yebrian1/Project-NUEVO/plot.png

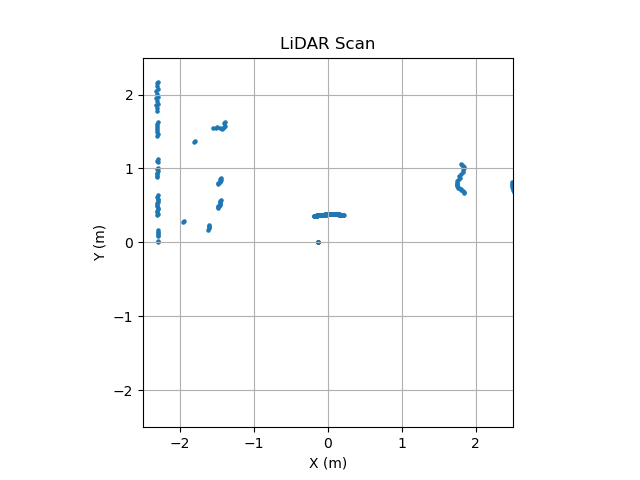
plot.png
