yebrian1/Project-NUEVO/robot_team.jpeg

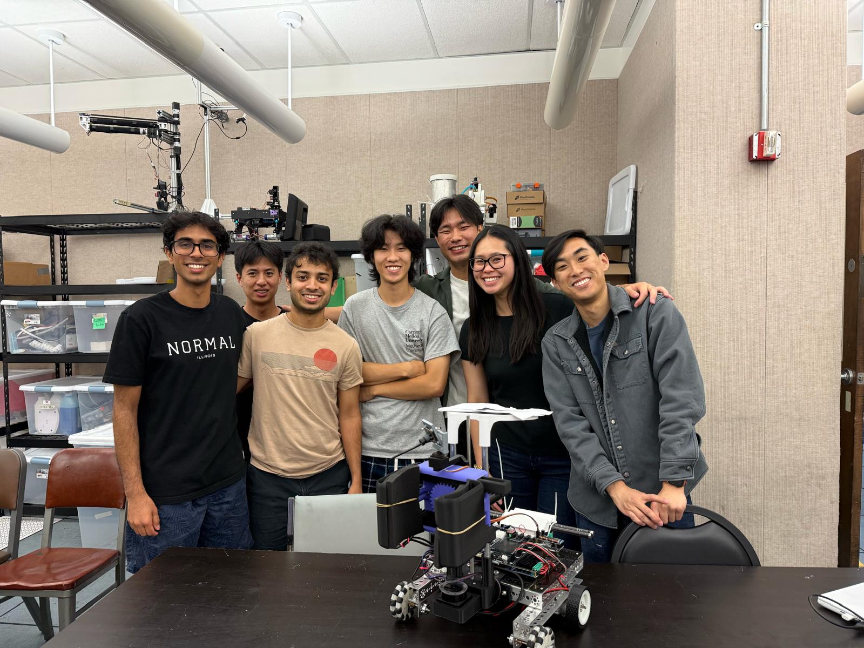
robot_team.jpeg
