yebrian1/Project-NUEVO/docs/lab_manual/Lab1_ROS2/main.tex

\documentclass{ol-softwaremanual}

% Packages used in this example
\usepackage{graphicx}  % for including images
\usepackage{microtype} % for typographical enhancements
\usepackage{amsmath}   % for equations and mathematics
\usepackage{minted}    % for styled code blocks (requires -shell-escape + Pygments)
\usepackage{hyperref}  % for hyperlinks
\usepackage[a4paper,top=4.2cm,bottom=4.2cm,left=3.5cm,right=3.5cm]{geometry}

% Additional packages for lab content
\usepackage{enumitem}
\usepackage{changepage}  % for adjustwidth (wider code blocks)

% Code block style: light gray background, small monospace font, line wrapping
\setminted{style=friendly, bgcolor=gray!10, fontsize=\small, breaklines=true, breakanywhere=true}

% Wider code blocks: extend codemargin into each margin, normal text width unchanged
\newlength{\codemargin}
\setlength{\codemargin}{1.0cm}
\AddToHook{env/minted/before}{%
  \begin{adjustwidth}{-\codemargin}{-\codemargin}%
  \addtolength{\hsize}{2\codemargin}%
}
\AddToHook{env/minted/after}{\end{adjustwidth}}

% Give LaTeX extra inter-word stretch to avoid overfull boxes from long \texttt paths
\setlength{\emergencystretch}{2em}

% Machine-location badges for task headings
%   \onlaptop  — green badge, steps performed on the student laptop
%   \onrpi     — blue badge,  steps performed on the Raspberry Pi
\newcommand{\onlaptop}{%
  \,\colorbox{green!25}{\footnotesize\sffamily\bfseries Laptop}}
\newcommand{\onrpi}{%
  \,\colorbox{blue!20}{\footnotesize\sffamily\bfseries RPi}}
\newcommand{\onui}{%
  \,\colorbox{yellow!50}{\footnotesize\sffamily\bfseries UI (browser)}}

% Machine-context callout used at the start of each Task subsection
%   #1 = machine label text,  #2 = brief description
\newcommand{\machinebox}[2]{%
  \par\noindent
  \colorbox{gray!12}{\parbox{\dimexpr\linewidth-2\fboxsep}{%
    \small\sffamily\textbf{Where to run:} #1 \quad\textbar\quad #2}}%
  \par\smallskip}

% Custom macros used in this example document
\newcommand{\doclink}[2]{\href{#1}{#2}}
\newcommand{\cs}[1]{\texttt{\textbackslash #1}}

% Match original template cover spacing:
%   ~30% whitespace, logo, large gap, title+version, vfill, author+date
\makeatletter
\renewcommand\maketitle{%
  \begin{titlepage}
  \centering
  \vspace*{0.18\textheight}
  \@logocmd\par
  \vspace{0.10\textheight}
  {\huge\bfseries\@title\par}
  \bigskip
  {\Large\@ver\par}
  \vfill
  {\Large\@author\par}
  \@date
  \vspace{0.06\textheight}
  \end{titlepage}
}
\makeatother

% Frontmatter data; appears on title page
\title{Lab 1: ROS2 Introduction and System Integration}
\version{0.1.3}
\author{162 TAs and Maclab members}
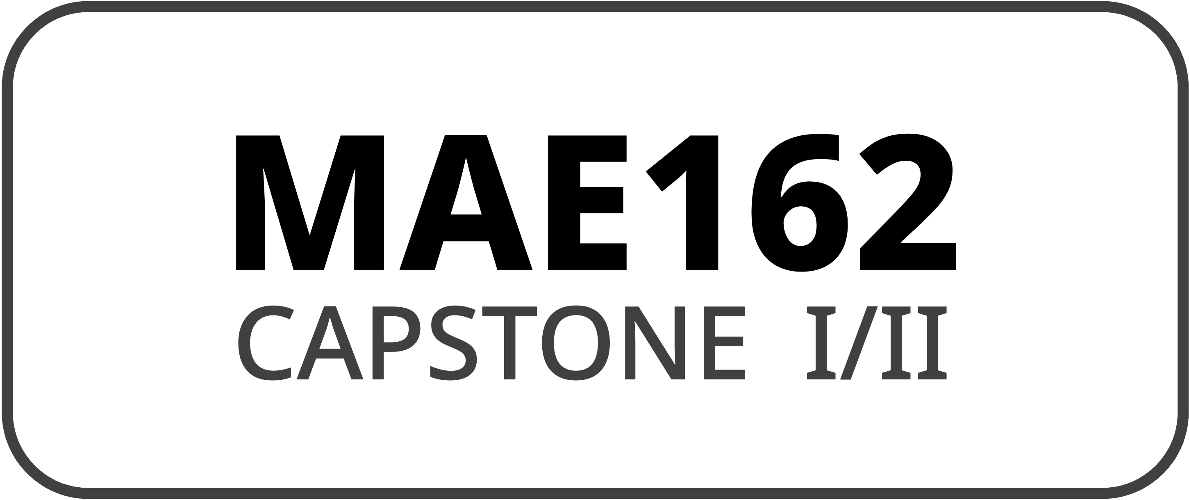
[picture p5: docs/lab_manual/Lab1_ROS2/figures/capstone.png]
\softwarelogo{}

\begin{document}

\maketitle

\centerline{\textbf{Warning!}}
\begin{itemize}
    \item No food and drinks are allowed in the lab.
    \item Be careful with the hardware especially the electronics.  Any liquid spill can cause a short circuit, potentially significantly delaying your progress.
    \item Never generate a short circuit.
    \item Connect electric wires only when you are sure about what you are doing.
    \item Be gentle to the buttons! You are liable to the damage made to the robot and its electronics.
    \item Wash your hands after each experiment, some components may contain some lead.
    \item Do not run experiments on the table for the chance the robot may fall on the floor and get damaged.
\end{itemize}
\pagebreak

\tableofcontents
\newpage

\section{System Architecture}

Figure~\ref{fig:system_architecture} shows the full system architecture of Project NUEVO.
The system is divided into several blocks that communicate over well-defined interfaces.
Understanding this structure is essential for debugging and extending the robot.
For a comprehensive reference covering all subsystems, see
\doclink{https://github.com/pochihh/Project-NUEVO/blob/main/docs/manual/MANUAL.md}{\texttt{docs/manual/MANUAL.md}}.

\begin{figure}[h]
  \centering
  
  \caption{System Architecture.}
  \label{fig:system_architecture}
\end{figure}

\subsection*{PCB and Firmware}
The custom PCB hosts an \textbf{Arduino Mega 2560} microcontroller and breaks out
the following hardware channels:

\begin{itemize}
  \item \textbf{4 DC motor channels} with quadrature encoder feedback
  \item \textbf{4 stepper motor channels} (A4988/DRV8825 drivers)
  \item \textbf{16 servo channels} via a PCA9685 I\textsuperscript{2}C PWM controller
  \item \textbf{IMU} (ICM-20948: accelerometer, gyroscope, magnetometer)
  \item \textbf{Voltage monitoring} for the battery rail, 5\,V rail, and servo rail
  \item \textbf{User I/O}: buttons, discrete LEDs, and NeoPixel RGB LEDs
  \item \textbf{Limit switches} and expandable ultrasonic sensor slots
\end{itemize}

The firmware is the only component that directly controls the actuators and reads
hardware encoders; all other layers communicate with it through the bridge.

For full firmware details refer to:
\begin{itemize}
  \item \doclink{https://github.com/pochihh/Project-NUEVO/blob/main/firmware/README.md}{\texttt{firmware/README.md}} --- build, upload, and configuration overview
  \item \doclink{https://github.com/pochihh/Project-NUEVO/blob/main/firmware/arduino/src/config.h}{\texttt{firmware/arduino/src/config.h}} --- all compile-time settings (channel counts, gains, rates)
  \item \doclink{https://github.com/pochihh/Project-NUEVO/blob/main/firmware/docs/architecture.md}{\texttt{firmware/docs/architecture.md}} --- runtime task structure and startup order
  \item \doclink{https://github.com/pochihh/Project-NUEVO/blob/main/docs/COMMUNICATION_PROTOCOL.md}{\texttt{docs/COMMUNICATION\_PROTOCOL.md}} --- TLV protocol, message catalog, and state machine
  \item \doclink{https://github.com/pochihh/Project-NUEVO/blob/main/tlv_protocol/TLV_Payloads.md}{\texttt{tlv\_protocol/TLV\_Payloads.md}} --- exact payload byte layouts and IDs
\end{itemize}

\subsection*{Bridge}
The bridge is a Python process running on the \textbf{Raspberry Pi~5}.
It owns the single UART connection to the Arduino (\texttt{/dev/ttyAMA0} at 200\,kbaud)
and translates between the compact TLV wire protocol and higher-level interfaces.
In addition to the transport layer, the bridge runs a \textbf{FastAPI/WebSocket server}
that serves the NUEVO web UI.
When running inside the ROS2 Docker container, the bridge also publishes and subscribes
to ROS2 topics and services, acting as the boundary between the real-time firmware world
and the robot application layer.

Refer to:
\begin{itemize}
  \item \doclink{https://github.com/pochihh/Project-NUEVO/blob/main/docs/ros2/bridge_runtime.md}{\texttt{docs/ros2/bridge\_runtime.md}} --- bridge architecture, shared runtime model, and reset recovery
  \item \doclink{https://github.com/pochihh/Project-NUEVO/blob/main/docs/COMMUNICATION_PROTOCOL.md}{\texttt{docs/COMMUNICATION\_PROTOCOL.md}} --- TLV protocol, message catalog, and state machine
\end{itemize}

\subsection*{NUEVO UI}
The NUEVO UI is a \textbf{React} web application served by the bridge backend.
It provides a dashboard for testing and monitoring all hardware in real time:
motor speed setpoints and feedback, stepper positions, servo angles, LED color,
user button states, IMU readings, voltage levels, and odometry.
You access it from any browser on the same network by navigating to the
Raspberry Pi's IP address at port~8000.

Refer to:
\begin{itemize}
  \item \doclink{https://github.com/pochihh/Project-NUEVO/blob/main/ros2_ws/README.md}{\texttt{ros2\_ws/README.md}} --- build instructions for the frontend and how to start the bridge that serves the UI
\end{itemize}

\subsection*{Robot Node}
The \texttt{robot} ROS2 package is where high-level \textbf{decision-making and path planning}
code lives.
It subscribes to sensor and state topics published by the bridge, computes motion commands,
and publishes velocity setpoints back to the bridge for execution.
In this lab the robot node is a scaffold; you will extend it in future labs.

\subsection*{Sensor Node}
The \texttt{sensors} ROS2 package handles \textbf{Raspberry Pi--connected sensors}
that are not part of the Arduino firmware, such as GPS receivers and external range sensors
(LiDAR, ultrasonic modules, etc.).
It publishes sensor data as ROS2 topics for the robot node to consume.

\subsection*{Vision Node}
The \texttt{vision} ROS2 package handles the \textbf{camera pipeline and object detection}.
It reads frames from the camera, runs inference (e.g.\ YOLO), and publishes detection results
as ROS2 topics.
The vision dependencies (OpenCV, libcamera, YOLO) are heavier than the rest of the stack
and are added to the Docker image separately.

Refer to the following for the Robot, Sensor, and Vision nodes:
\begin{itemize}
  \item \doclink{https://github.com/pochihh/Project-NUEVO/blob/main/docs/ros2/ros2_nodes_design.md}{\texttt{docs/ros2/ros2\_nodes\_design.md}} --- package layout, design principles, and topic/service naming
  \item \doclink{https://github.com/pochihh/Project-NUEVO/blob/main/ros2_ws/README.md}{\texttt{ros2\_ws/README.md}} --- Docker workflow, node startup order, and ROS2 API overview
\end{itemize}

\subsection*{Why ROS2 and Docker?}
With this architecture, each component has a single responsibility and communicates
through a standardised message-passing system.
Adding a new sensor, planner, or perception algorithm means writing a new node
that subscribes and publishes standard topics --- the rest of the system does not change.
Docker ensures that every team member and every Raspberry Pi runs the \emph{exact same}
software environment regardless of the host operating system, eliminating
``it works on my machine'' problems and making deployment to the robot a one-command step.

\section{ROS2 Introduction}

\subsection{Core Concepts}

ROS2 (Robot Operating System~2) is an open-source middleware framework for building
robot software.
Despite the name it is not an operating system: it is a set of libraries, tools, and
conventions that run on top of a standard OS and let independently developed programs
communicate with each other cleanly.

\textbf{Nodes} are the basic executable units.
Each node is a process (or a thread within a process) that performs one focused task ---
reading a sensor, running a controller, publishing odometry.
In this project: \texttt{bridge}, \texttt{robot}, \texttt{sensor\_node}, and
\texttt{vision\_node} are each a separate node.

\textbf{Topics} are named communication channels that carry a stream of messages.
A node that produces data \emph{publishes} to a topic; a node that needs that data
\emph{subscribes} to it.
Topics are asynchronous and many-to-many.
For example, the bridge node publishes DC motor state on \texttt{/dc\_state\_all}
and the robot node subscribes to that topic.

\textbf{Messages} define the data structure for a topic.
They are declared in \texttt{.msg} files inside the \texttt{bridge\_interfaces} package
and compiled into language-specific code automatically.
\texttt{bridge\_interfaces/msg/DCStateAll} and \texttt{bridge\_interfaces/msg/SystemPower}
are examples used in this project.

\textbf{Services} are synchronous request--reply interactions.
A node that handles a service advertises it; another node calls it and waits for
a response.
Use services for discrete operations where you need to know whether the action
succeeded.
In this project, firmware state transitions (IDLE $\to$ RUNNING, triggering an E-stop)
use the \texttt{/set\_firmware\_state} service.

\textbf{Packages} are the unit of organisation and distribution.
A package groups related nodes, message definitions, and launch files.
This project has five packages:
\texttt{bridge\_interfaces} (message/service definitions),
\texttt{bridge} (ROS wrapper around the firmware bridge),
\texttt{robot} (motion planning),
\texttt{sensors} (Pi-side sensors), and
\texttt{vision} (camera and detection).

\medskip
\noindent\textit{Keywords for further learning:}
ROS2 publisher/subscriber, colcon build, \texttt{ros2 topic echo}, \texttt{ros2 node info},
QoS policies, launch files, parameter server, tf2 transforms, RViz2, rqt.

\subsection{Docker for ROS2}

Modern robots are developed by teams working on different machines with different
operating systems --- macOS, Windows, Ubuntu.
ROS2 Jazzy officially targets Ubuntu 24.04; running it natively on macOS or Windows
requires significant manual setup that is fragile and hard to reproduce.
Docker solves this by packaging the entire ROS2 environment --- OS libraries,
ROS installation, workspace build --- into a single \emph{container image}.
Everyone on the team starts the same image, so the software environment is
\emph{identical} whether you are developing on a laptop or deploying to the Raspberry Pi.
This also means updating the environment is a \texttt{docker compose build} rather than
a multi-step manual procedure.

In this project the Docker image contains ROS2 Jazzy, the project workspace,
and all Python runtime dependencies.
Two compose files are provided:

\begin{itemize}
  \item \texttt{ros2\_ws/docker/docker-compose.rpi.yml} --- for the Raspberry Pi with real hardware
  \item \texttt{ros2\_ws/docker/docker-compose.vm.yml} --- for macOS / Windows development (mock bridge)
\end{itemize}

\noindent\textit{Keywords for further learning:}
Dockerfile, Docker image vs.\ container, \texttt{docker compose}, volume mounts,
container networking, \texttt{docker exec}, base images.

\section{Raspberry Pi Safety and Usage}

The Raspberry Pi~5 is the compute brain of your robot.
A damaged or corrupted RPi means your whole team is blocked until it is
re-imaged or replaced --- which can take an entire lab session.
The failures we see most often are \emph{entirely preventable}.
Read this section before touching the hardware.

\subsection*{Power}

\begin{itemize}
  \item \textbf{Two valid power sources:}
        \begin{itemize}
          \item \textbf{Supplied USB-C PD adapter} (5\,V / 5\,A) --- use this
                at your bench when the robot battery is not connected.
          \item \textbf{Robot battery via the PCB} --- the PCB's onboard 5\,V
                rail is rated at 6\,A and includes a hot-swap circuit that
                safely switches between battery and bench supply.
                This is the intended power source when the robot is running
                autonomously.
        \end{itemize}
  \item \textbf{Never use a phone charger, laptop USB port, or cheap power bank.}
        These cannot supply enough current; the resulting voltage drop causes
        random crashes and SD card corruption.
  \item \textbf{Never wire the battery directly to the RPi}, bypassing the PCB.
        The PCB regulator and hot-swap circuit are there for a reason.
  \item \textbf{Never hot-swap the SD card.}
        If the card must be removed, shut down first (see below).
\end{itemize}

\subsection*{Shutdown procedure --- the most important habit}

The RPi runs a Linux filesystem.
Pulling the power while the OS is writing to the SD card --- which happens
constantly in the background --- \textbf{corrupts the filesystem}.
A corrupted SD card requires a full re-image and you lose all local work that
was not pushed to GitHub.

\medskip
\noindent\textbf{Always shut down properly before removing power:}

\begin{minted}{bash}
sudo shutdown -h now
\end{minted}

Wait for the green activity LED to stop blinking and go dark (roughly 10--15\,s),
\emph{then} unplug the power cable.
This also applies when you are finished for the day and when packing up the robot.

\subsection*{GPIO pins}

\begin{itemize}
  \item \textbf{GPIO logic level is 3.3\,V.}
        The RPi is \emph{not} 5\,V tolerant on its GPIO pins.
        Connecting a 5\,V signal directly to any GPIO pin will destroy that
        pin and may kill the entire SoC.
        Always use a level shifter or voltage divider when interfacing with
        5\,V peripherals.
  \item \textbf{Maximum current per GPIO pin is 16\,mA} (8\,mA recommended).
        Never drive an LED, motor, or relay directly from a GPIO pin without a
        current-limiting resistor or driver IC.
  \item \textbf{Never short GPIO pins together}, and keep metal objects (tools,
        loose wires, PCB offcuts) away from the board when it is powered.
        A momentary short across the wrong pins can instantly destroy the board.
  \item \textbf{Ground yourself} before handling the board.
        Touch a grounded metal surface (e.g.\ a PC chassis) or wear an ESD
        wrist strap.
        Electrostatic discharge is invisible and silent --- and permanently damages
        chips.
\end{itemize}

\subsection*{Physical handling}

\begin{itemize}
  \item Hold the board by its edges.
        Finger pressure on chips or connectors can crack solder joints.
  \item Keep the board on a \textbf{non-conductive surface} (the anti-static bag it came
        in, or a plastic tray).
        Placing it on a metal bench or a conductive surface shorts the bottom
        pads.
  \item Do not stack anything on top of the RPi when it is running.
        The processor generates significant heat; blocking airflow causes thermal
        throttling and instability.
\end{itemize}

\subsection*{SD card hygiene}

\begin{itemize}
  \item \textbf{Push your work to GitHub immediately.}
        SD cards have a finite write endurance and \emph{will} eventually fail.
        Any work that only exists on the RPi can vanish at any time (see also
        Task~1.3).
  \item Avoid running \texttt{apt upgrade} or long package installs when the
        robot is on battery --- a power cut mid-upgrade corrupts the package
        database and often requires a re-image.
  \item If the RPi fails to boot, do \emph{not} keep trying to power-cycle it.
        Note down any error messages on the HDMI output or status LEDs and ask
        the TAs for help.
\end{itemize}

\section{Lab Activities}

\subsection{Task 1: Set Up Your Repository}\label{sec:task1}

\machinebox{\onlaptop\ your laptop \textbar\ \onrpi\ Raspberry Pi}{The repo must be cloned on \emph{both} machines. Your laptop uses it for firmware (Task~\ref{sec:task2}); the RPi uses it for ROS2 (Task~\ref{sec:task3}). Day-to-day edits are made on your laptop, then pulled onto the RPi.}

In this course you will modify the Project NUEVO codebase to add features and
tune your robot.
Each team should work in their own copy of the repository so that your changes
do not affect other teams and so you can safely experiment.

\subsubsection{Fork the Repository\onlaptop}

\begin{enumerate}
  \item Go to \doclink{https://github.com/pochihh/Project-NUEVO}{github.com/pochihh/Project-NUEVO}.
  \item Click \textbf{Fork} (top-right corner) to create a copy under your own GitHub account.
    \hfill\textit{(keyword: fork)}
  \item On your forked repository page, go to \textbf{Settings $\to$ Collaborators}
        and add your teammates as collaborators so everyone can push to the same fork.
    \hfill\textit{(keyword: collaborators, repository permissions)}
\end{enumerate}

\subsubsection{Clone the Repository --- Laptop\onlaptop}

Clone your fork onto your laptop.
You will use this copy to edit firmware, run MATLAB, and push changes to GitHub.

\begin{minted}{bash}
git clone https://github.com/<your-username>/Project-NUEVO.git
cd Project-NUEVO
\end{minted}
\hfill\textit{(keyword: clone, remote)}

\subsubsection{Clone the Repository --- Raspberry Pi\onrpi}\label{ssec:clone-rpi}

SSH into the Raspberry Pi and clone the \emph{same fork} there.
The RPi copy is what Docker mounts when running the ROS2 workspace in Task~\ref{sec:task3}.

\begin{minted}{bash}
git clone https://github.com/<your-username>/Project-NUEVO.git
cd Project-NUEVO
\end{minted}

\noindent You do not normally edit code directly on the RPi.
The typical workflow is: edit on your laptop $\to$ commit $\to$ push to GitHub
$\to$ \texttt{git pull} on the RPi to bring in the latest changes.
You can make local changes on the RPi and push them back to GitHub if needed,
but be careful not to let the two clones diverge---always pull on one machine
before editing, and push promptly so your teammates stay in sync.

\noindent\textbf{Important:} the Raspberry Pi is embedded hardware and can lose
power unexpectedly, suffer SD card corruption, or need to be re-imaged at any
time. Any work that exists \emph{only} on the RPi can be lost without warning.
\textbf{Push every change to GitHub as soon as you make it.}
Never leave uncommitted or unpushed work sitting on the RPi.

\subsubsection{Daily Git Workflow\onlaptop}

Git lets your whole team work on the same codebase simultaneously.
Run these commands on your laptop:

\begin{enumerate}
  \item \textbf{Stage} the files you want to save.
\begin{minted}{bash}
git add <filename>
\end{minted}
        \hfill\textit{(keyword: staging area, working tree)}

  \item \textbf{Commit} to record a snapshot with a short message describing what you did.
\begin{minted}{bash}
git commit -m "brief description of change"
\end{minted}
        \hfill\textit{(keyword: commit, commit message)}

  \item \textbf{Push} to upload your commits to GitHub so teammates (and the RPi) can see them.
\begin{minted}{bash}
git push
\end{minted}
        \hfill\textit{(keyword: push, origin)}

  \item \textbf{Pull} to download your teammates' latest commits before you start working.
\begin{minted}{bash}
git pull
\end{minted}
        \hfill\textit{(keyword: pull, merge, rebase, merge conflict)}
\end{enumerate}

\subsubsection{Pull Updates from the Original Repository\onlaptop}

Bug fixes and new features will be released to the original repository during the
course.
To bring them into your fork, add the original repository as a second remote and
pull from it:

\begin{enumerate}
  \item Add the original repository as the \texttt{upstream} remote (one-time setup):
\begin{minted}{bash}
git remote add upstream https://github.com/pochihh/Project-NUEVO.git
\end{minted}
        \hfill\textit{(keyword: remote, upstream)}

  \item Fetch and merge the latest changes from upstream into your local branch (for updates \textbf{in the future}):
\begin{minted}{bash}
git fetch upstream
git merge upstream/main
\end{minted}
        \hfill\textit{(keyword: fetch, merge, fast-forward)}

  \item Push the merge result (the updates) to your fork:
\begin{minted}{bash}
git push
\end{minted}
\end{enumerate}

\subsection{Task 2: Flash the Firmware}\label{sec:task2}

\machinebox{\onlaptop\ your laptop}{Arduino IDE is installed on your laptop; the Arduino is connected via USB.}

The Arduino Mega firmware must be flashed onto the robot before the bridge can
communicate with it.
Full details and troubleshooting are in
\doclink{https://github.com/pochihh/Project-NUEVO/blob/main/firmware/README.md}{\texttt{firmware/\allowbreak README.md}}.

\subsubsection{Prerequisites\onlaptop}

\begin{enumerate}
  \item Install \textbf{Arduino IDE 2.x} and the \textbf{Arduino AVR Boards} core.
  \item Increase the serial buffer size so the firmware UART link does not overflow.
        Create or edit (if exists already) \texttt{platform.local.txt} for the installed AVR core and add the following text in it:
\begin{minted}{text}
compiler.cpp.extra_flags=-DSERIAL_RX_BUFFER_SIZE=512 -DSERIAL_TX_BUFFER_SIZE=256
\end{minted}
        Typical file locations (replace \texttt{1.8.7} with your installed AVR core version):

        \textit{macOS:}
\begin{minted}{text}
~/Library/Arduino15/packages/arduino/hardware/avr/1.8.7/platform.local.txt
\end{minted}
        \textit{Windows:}
\begin{minted}{text}
C:\Users\<your-user>\AppData\Local\Arduino15\packages\arduino\hardware\avr\1.8.7\platform.local.txt
\end{minted}
\end{enumerate}

\subsubsection{Build and Upload\onlaptop}

\begin{enumerate}
  \item Open \texttt{firmware/arduino/arduino.ino} in Arduino IDE.
  \item Select board: \textbf{Arduino Mega or Mega~2560}.
  \item Select the correct COM / serial port for the connected Arduino.
  \item Click \textbf{Verify} to confirm the firmware compiles without errors.
  \item Click \textbf{Upload} to flash the firmware onto the board.
\end{enumerate}

After a successful upload the board resets and the firmware starts running.
Confirm by opening the Arduino IDE Serial Monitor at 115\,200 baud and checking
for heartbeat output.

\subsection{Task 3: Bring Up the ROS2 Environment and NUEVO UI}\label{sec:task3}

\machinebox{\onrpi\ Raspberry Pi (SSH or direct terminal)}{Most steps run on the RPi. The final step (Access the NUEVO UI) opens in a browser on any device on the same network. Make sure you have already cloned your fork on the RPi (Section~\ref{ssec:clone-rpi}) and run \texttt{git pull} to get the latest code before starting.}

In this task you will start the Docker container on the Raspberry Pi, launch the
bridge node, and verify all hardware using the NUEVO web UI.
Full setup details are in
\doclink{https://github.com/pochihh/Project-NUEVO/blob/main/ros2_ws/README.md}{\texttt{ros2\_ws/README.md}}.

\subsubsection{Raspberry Pi UART Setup (one-time)\onrpi}

The bridge communicates with the Arduino over the RPi hardware UART.
Enable it by editing the RPi boot configuration files:

\begin{enumerate}
  \item Add the following lines to \texttt{/boot/firmware/config.txt}:
\begin{minted}{text}
enable_uart=1
dtoverlay=uart0-pi5
\end{minted}

  \item Remove any \texttt{console=serial0} or \texttt{console=ttyAMA0} entries
        from \texttt{/boot/firmware/cmdline.txt} so the OS does not claim the port.

  \item Reboot and verify: \texttt{ls -l /dev/ttyAMA0} should show a character
        device owned by the \texttt{dialout} group.
\end{enumerate}

\subsubsection{Install Node.js and npm (one-time)\onrpi}

The NUEVO UI frontend build uses \texttt{npm}. Install Node.js and npm on the
Raspberry Pi host first:

\begin{minted}{bash}
sudo apt update
sudo apt install -y nodejs npm
node -v
npm -v
\end{minted}

For this project, \texttt{node -v} should report a reasonably modern version
(Node 18 or newer is a safe baseline).

\subsubsection{Build the Frontend (one-time)\onrpi}

The bridge serves the NUEVO web UI as a pre-built static bundle.
Build it once from the repository root:

\begin{minted}{bash}
cd nuevo_ui/frontend
npm ci
npm run build
cd ../..
cp -r nuevo_ui/frontend/dist/. nuevo_ui/backend/static/
\end{minted}

\subsubsection{Install Docker (one-time)\onrpi}

For this class project, the simplest Docker setup on the Raspberry Pi is the
official Docker convenience script:

\begin{minted}{bash}
curl -fsSL https://get.docker.com -o get-docker.sh
sudo sh get-docker.sh
sudo usermod -aG docker $USER
newgrp docker
docker --version
docker compose version
\end{minted}

\textbf{Note:} if \texttt{newgrp docker} does not take effect cleanly in your
shell, log out and log back in once, then re-run the version checks above.

\subsubsection{Start the Docker Container\onrpi}

From the repository root on the Raspberry Pi:

\begin{minted}{bash}
COMPOSE=ros2_ws/docker/docker-compose.rpi.yml
docker compose -f $COMPOSE build
docker compose -f $COMPOSE up -d
docker compose -f $COMPOSE logs -f ros2_runtime
\end{minted}

Wait until the log shows that \texttt{colcon build} finished and the container is ready.

\subsubsection{Launch the Bridge Node\onrpi}

Open a shell inside the running container and start the bridge:

\begin{minted}{bash}
docker compose -f $COMPOSE exec ros2_runtime bash
source /opt/ros/jazzy/setup.bash
source /ros2_ws/install/setup.bash
ros2 run bridge bridge
\end{minted}

The bridge node connects to the Arduino, starts the WebSocket server, and begins
publishing ROS2 topics.

\subsubsection{Access the NUEVO UI\onui}

Open a browser on any device on the same network and navigate to:
\begin{center}
  \texttt{http://<raspberry-pi-ip>:8000}
\end{center}

Login credentials: username \texttt{user}, password \texttt{162}.
\textbf{Change your password after first login.}

Use the UI to test each hardware feature:
\begin{itemize}
  \item Set stepper motor positions and verify movement.
  \item Command servo angles and observe the mechanical response.
  \item Change LED colors via the colour picker.
  \item Press each user button and confirm the indicator updates.
  \item Check IMU readings (accelerometer, gyroscope) for expected values.
  \item Monitor the battery voltage level on the power panel.
\end{itemize}

\subsection{Task 4: DC Motor PI Tuning and Step Response}\label{sec:task4}

\machinebox{\onlaptop\ your laptop \textbar\ \onui\ NUEVO UI \textbar\ \onrpi\ RPi}{MATLAB analysis and gain calculations run on your laptop. Motor commands and data recording use the NUEVO UI in your browser. The RPi must be running the bridge node from Task~\ref{sec:task3}.}

In this task you will tune the PI velocity controller for one DC motor and record
step responses to evaluate your design.
The goal is to transition from the default gains to a set of gains that you can
justify from a simple model of the motor dynamics.

\subsubsection{Model-Based PI Design (Optional)\onui\onlaptop}\label{ssec:model-pi}

A DC motor's velocity dynamics can be approximated as a first-order linear system:
\begin{equation}
  G(s) = \frac{K}{\tau s + 1}
  \label{eq:motor_model}
\end{equation}
where $K$ is the steady-state gain (ticks/s per PWM unit) and $\tau$ is the time
constant (seconds).
You can identify both parameters from an open-loop step response.

\paragraph{Step 1: Measure the open-loop step response.}
In the NUEVO UI, switch the motor to \textbf{PWM mode} and apply a step change in
PWM from 0 to a fixed value (e.g.\ 128 out of 255, or about 50\,\%).
Record the velocity $\omega(t)$ response using the UI's plot feature.

From the recorded curve:
\begin{itemize}
  \item $K = \omega_{ss} / u$ \quad where $u$ is the \emph{actual integer PWM value you
        applied} (0--255, \emph{not} 1).
        For example, if you applied PWM\,=\,128 and the motor settled at
        $\omega_{ss} = 980$\,ticks/s, then $K = 980/128 \approx 7.66$\,ticks/s per PWM
        unit.
  \item $\tau$ = the time at which $\omega(t)$ first reaches $63.2\,\%$ of $\omega_{ss}$
        (read directly from the step-response plot).
\end{itemize}

\paragraph{Step 2: Design the continuous-time PI gains.}
A PI controller $C(s) = K_p + K_i/s$ with plant $G(s)$ gives a second-order
closed-loop response.
Matching coefficients to the standard form $s^2 + 2\zeta\omega_n s + \omega_n^2$
yields:
\begin{equation}
  K_p = \frac{2\zeta\omega_n\tau - 1}{K}, \qquad
  K_i = \frac{\omega_n^2 \,\tau}{K}
  \label{eq:pi_gains}
\end{equation}

Choose a desired damping ratio $\zeta = 0.7$ (a good default that balances speed and
overshoot).
Select $\omega_n$ based on a rise-time or settling-time specification of your choice,
then compute $K_p$ and $K_i$ from Equations~\eqref{eq:pi_gains}.

\paragraph{Step 3: Convert to discrete time.}
The firmware PI controller runs at $f_s = 200$\,Hz, so the sample period is
$T_s = 1/200 = 0.005$\,s.
Because the gains from Step~2 are continuous-time, they must be discretized before
they can be entered into the firmware.
Use the \textbf{Tustin (bilinear)} transform, which substitutes
\[
  s \;\longrightarrow\; \frac{2}{T_s}\,\frac{z-1}{z+1}
\]
and maps the continuous-time PI controller to a discrete difference equation.
In MATLAB, the conversion is one line:

\begin{minted}{matlab}
Ts = 0.005;                         % sample period (s)  -- 200 Hz
C_s = pid(Kp, Ki);                  % continuous-time PI
C_z = c2d(C_s, Ts, 'tustin');       % discretize via bilinear transform
display(C_z)                        % inspect the result
\end{minted}

The resulting \texttt{C\_z} object contains the discrete-time coefficients.
You can extract the numerator and denominator and verify the DC gain matches
$K_p + K_i / (j\omega)$ at low frequency.
The firmware implements the equivalent difference equation internally;
you only need to enter $K_p$ and $K_i$ (the continuous-time values) through
the UI---the firmware's built-in discretization handles the rest at runtime.

\subsubsection{Simple Observation (Alternative)\onui}\label{ssec:simple-obs}

If you prefer a faster approach, skip the model identification and instead adjust
$K_p$ and $K_i$ manually while observing the step response:
increase $K_p$ to speed up the response, increase $K_i$ to eliminate steady-state
error, and reduce both if the response oscillates.

\subsubsection{Record and Compare Step Responses\onui\onlaptop}

Using the NUEVO UI, command a velocity step from 0 to 1000 ticks/s and record the
response for:
\begin{enumerate}
  \item The \textbf{default} PI gains (as shipped in \texttt{firmware/\allowbreak arduino/\allowbreak src/\allowbreak config.h}).
  \item Your \textbf{tuned} gains from Section~\ref{ssec:model-pi} or~\ref{ssec:simple-obs}.
\end{enumerate}

On each plot, annotate:
\begin{itemize}
  \item Rise time $t_r$ (time to go from 10\,\% to 90\,\% of the setpoint)
  \item Percent overshoot $M_p$
  \item Settling time $t_s$ (time to stay within $\pm 5\,\%$ of the setpoint)
  \item Steady-state error $e_{ss}$
\end{itemize}

Figure~\ref{fig:example_step} shows an example plot.

\begin{figure}[h]
  \centering
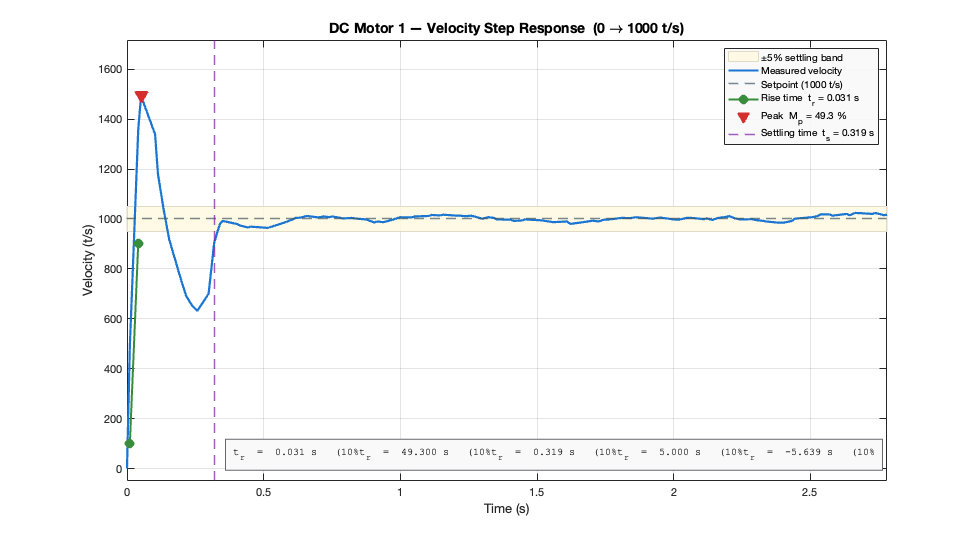
[picture p6: docs/lab_manual/Lab1_ROS2/figures/example_step.png]
  
  \caption{Example annotated velocity step response (0 $\to$ 1000\,ticks/s).
           The shaded region is the $\pm5\,\%$ settling band.}
  \label{fig:example_step}
\end{figure}

\section{Lab Deliverables}

Show your final step response plots to the TAs.
Your plots should include both the default and tuned step responses with the
performance metrics annotated.
Justify your tuned gains: explain how you arrived at your $K_p$ and $K_i$ values,
whether through the model-based approach or manual tuning, and discuss the
trade-offs you observed between rise time, overshoot, and settling time.

\end{document}
