yebrian1/Project-NUEVO/docs/lab_manual/Lab1_ROS2/dc_motor_1_0331_15-28.csv

Frame Index | Time (s) | Position (ticks) | Velocity (t/s) | Current (mA) | PWM
0 | 0 | 0 | 0 | -1 | 0
1 | 0.041271240234375 | 0 | 0 | -1 | 0
2 | 0.0618193359375 | 0 | 0 | -1 | 0
3 | 0.08243310546875 | 0 | 0 | -1 | 0
4 | 0.102903076171875 | 0 | 0 | -1 | 0
5 | 0.1441796875 | 0 | 0 | -1 | 0
6 | 0.164718017578125 | 0 | 0 | -1 | 0
7 | 0.185482666015625 | 0 | 0 | -1 | 0
8 | 0.195895263671875 | 0 | 0 | -1 | 0
9 | 0.247421142578125 | 0 | 0 | -1 | 0
10 | 0.257862060546875 | 0 | 0 | -1 | 0
11 | 0.28854052734375 | 0 | 0 | -1 | 0
12 | 0.29895654296875 | 0 | 0 | -1 | 0
13 | 0.330059326171875 | 0 | 0 | -1 | 0
14 | 0.340563232421875 | 0 | 0 | -1 | 0
15 | 0.3715439453125 | 0 | 0 | -1 | 0
16 | 0.38197802734375 | 0 | 0 | -1 | 0
17 | 0.40298046875 | 0 | 0 | -1 | 0
18 | 0.423476806640625 | 0 | 0 | -1 | 0
19 | 0.444154296875 | 0 | 0 | -1 | 0
20 | 0.464763671875 | 0 | 0 | -1 | 0
21 | 0.485376220703125 | 0 | 0 | -1 | 0
22 | 0.495789794921875 | 0 | 0 | -1 | 0
23 | 0.5269541015625 | 0 | 0 | -1 | 0
24 | 0.547535888671875 | 0 | 0 | -1 | 0
25 | 0.568413818359375 | 0 | 0 | -1 | 0
26 | 0.57886572265625 | 0 | 0 | -1 | 0
27 | 0.6303642578125 | 0 | 0 | -1 | 0
28 | 0.640788330078125 | 0 | 0 | -1 | 0
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
