yebrian1/Project-NUEVO/firmware/arduino/src/config.h

#define CONFIG_H
#define FIRMWARE_VERSION        0x00090900  // Version 0.9.9
#define TLV_PROTOCOL_VERSION_MAJOR 4
#define TLV_PROTOCOL_VERSION_MINOR 0
#define BOARD_REVISION          0       // 0 = unspecified / unknown
#define RPI_BAUD_RATE           250000  // High-speed stable rate for Mega2560 <-> RPi
#define HEARTBEAT_TIMEOUT_MS    500     // Disable actuators if heartbeat stops
#define I2C_INIT_CLOCK_HZ       100000
#define I2C_BUS_CLOCK_HZ        400000
#define SERVO_I2C_CLOCK_HZ      100000
#define I2C_WIRE_TIMEOUT_US     5000
#define UART_COMMS_FREQ_HZ      100     // UART service task
#define MOTOR_UPDATE_FREQ_HZ    200     // DC control compute round
#define SENSOR_UPDATE_FREQ_HZ   100     // Sensor dispatch task
#define IMU_UPDATE_FREQ_HZ      25      // IMU read + Fusion update cadence
#define USER_IO_FREQ_HZ         50      // LEDs / buttons / UI indications
#define STATUS_REPORTER_ENABLED 0       // 1 = emit [SYSTEM]/[TIMING]/[UART], 0 = disable
#define STATUS_REPORT_HZ        1       // Report frequency when enabled
#define FAULT_EVENT_LOG_ENABLED 1
#define FAULT_EVENT_MIN_INTERVAL_MS 100
#define DEBUG_BAUD_RATE         115200
#define DEBUG_LOG_BUFFER_SIZE   768
#define DEBUG_FLUSH_MAX_BYTES_PER_PASS 16
#define NUM_DC_MOTORS           4       // Total DC motor channels
#define DC_MOTOR_1_DIR_INVERTED 1       // 0=normal, 1=inverted
#define DC_MOTOR_2_DIR_INVERTED 1       // 0=normal, 1=inverted
#define DC_MOTOR_3_DIR_INVERTED 1       // 0=normal, 1=inverted
#define DC_MOTOR_4_DIR_INVERTED 1       // 0=normal, 1=inverted
#define NUM_STEPPERS            4       // Total stepper channels
#define NUM_SERVO_CHANNELS      16      // PCA9685 provides 16 channels
#define SERVO_CONTROLLER_ENABLED 1      // Enable PCA9685 servo driver
#define ENCODER_PPR             1440    // Pulses per revolution (manufacturer spec, for encoder_4x)
#define ENCODER_MAX_RPM         100     // Maximum expected motor RPM
#define ENCODER_2X              2       // 2x counting (phase A only)
#define ENCODER_4X              4       // 4x counting (both phases)
#define ENCODER_1_MODE          ENCODER_4X
#define ENCODER_2_MODE          ENCODER_4X
#define ENCODER_3_MODE          ENCODER_4X
#define ENCODER_4_MODE          ENCODER_4X
#define ENCODER_1_DIR_INVERTED  0       // 0=normal, 1=inverted
#define ENCODER_2_DIR_INVERTED  0       // 0=normal, 1=inverted
#define ENCODER_3_DIR_INVERTED  0       // 0=normal, 1=inverted
#define ENCODER_4_DIR_INVERTED  0       // 0=normal, 1=inverted
#define WHEEL_DIAMETER_MM   80.0f
#define WHEEL_BASE_MM       333.0f
#define INITIAL_THETA       90.0f
#define ODOM_LEFT_MOTOR     0 // MOTOR_1
#define ODOM_LEFT_MOTOR_DIR_INVERTED 0
#define ODOM_RIGHT_MOTOR    1 // MOTOR_2
#define ODOM_RIGHT_MOTOR_DIR_INVERTED 1
#define DC_PID_FREQ_HZ          800     // DC motor Timer1 round-robin slot (1.25 ms; 200 Hz per motor)
#define STEPPER_TIMER_FREQ_HZ   10000   // 10kHz interrupt rate (100µs period)
#define STEPPER_MAX_RATE_SPS    5000    // Maximum steps per second per motor
#define ENCODER_STALL_DETECTION     0    // 1=enabled, 0=disabled
#define ENCODER_FAIL_PWM_THRESHOLD  51   // ~20% of 255; below this = intentional slow/stop
#define ENCODER_FAIL_TIMEOUT_MS     500  // ms without encoder movement before fault declared
#define DC_CURRENT_SENSE_ENABLED    0    // 1=sample CT analog pins in DCMotor::service()
#define MOTOR_TASK_CATCHUP_BUDGET_US 1000 // max wall-clock catch-up budget per taskMotors() pass
#define UART_TASK_BUDGET_US      10000   // 10 ms = full 100 Hz tick period
#define PID_ISR_UART_BUDGET_US      80
#define STEPPER_ISR_UART_BUDGET_US  60
#define PID_ROUND_BUDGET_US    (1000000UL / MOTOR_UPDATE_FREQ_HZ)
#define RPI_SERIAL              Serial2 // Hardware serial port
class HardwareSerial;
class Print;
extern HardwareSerial &DEBUG_SERIAL_PORT;
extern Print &DEBUG_SERIAL;
#define TELEMETRY_SYS_STATE_RUN_MS        100
#define TELEMETRY_SYS_STATE_IDLE_MS       1000
#define TELEMETRY_SYS_POWER_RUN_MS        100
#define TELEMETRY_SYS_POWER_IDLE_MS       1000
#define TELEMETRY_DC_STATE_MS             50
#define TELEMETRY_STEP_STATE_MS           50
#define TELEMETRY_SERVO_STATE_MS          100
#define TELEMETRY_IMU_MS                  50
#define TELEMETRY_IMU_IDLE_MS             100
#define TELEMETRY_KINEMATICS_MS           40
#define TELEMETRY_KINEMATICS_IDLE_MS      100
#define TELEMETRY_IO_INPUT_STATE_MS       50
#define TELEMETRY_IO_OUTPUT_STATE_MS      100
#define DEVICE_ID               0x01    // Arduino device ID for TLV protocol
#define ENABLE_CRC_CHECK        1       // Enable CRC checks on TLV packets. Set to 0 to disable.
#define VELOCITY_LOWPASS_CONST  0.50f   // Low-pass weight on raw speed; y=(y+raw*k)/(1+k)
#define VELOCITY_ZERO_TIMEOUT   50      // Zero velocity timeout (milliseconds)
#define DEFAULT_POS_KP          5.0f
#define DEFAULT_POS_KI          0.0f
#define DEFAULT_POS_KD          0.5f
#define DEFAULT_VEL_KP          0.2f
#define DEFAULT_VEL_KI          4.0f
#define DEFAULT_VEL_KD          0.0f
#define PID_OUTPUT_MIN          -255    // Minimum PWM value
#define PID_OUTPUT_MAX          255     // Maximum PWM value
#define IMU_ENABLED             0
#define IMU_AD0_VAL             1       // SparkFun breakout default: AD0 high = 0x69
#define IMU_ACCEL_RANGE_G       2       // 2, 4, 8, or 16 g
#define IMU_GYRO_RANGE_DPS      250     // 250, 500, 1000, or 2000 dps
#define FUSION_GAIN             0.2f
#define FUSION_GYRO_RECOVERY_DPS 0.0f
#define FUSION_ACCEL_REJECTION  10.0f   // degrees of gravity disagreement
#define FUSION_MAG_REJECTION    20.0f   // degrees of magnetic disagreement
#define FUSION_RECOVERY_PERIOD  5       // seconds
#define ULTRASONIC_COUNT        0
#define MAG_CAL_MIN_SAMPLES     50
#define VBAT_ENABLED            1       // Battery voltage monitoring
#define V5_ENABLED              1       // 5V rail monitoring
#define VSERVO_ENABLED          1       // Servo rail monitoring
#define BATTERY_NIMH_8CELL    1   //  8-cell NiMH,  9.6 V nominal
#define BATTERY_NIMH_10CELL   2   // 10-cell NiMH, 12.0 V nominal  ← DEFAULT
#define BATTERY_LIPO_2S       3   //  2S LiPo,  7.4 V nominal
#define BATTERY_LIPO_3S       4   //  3S LiPo, 11.1 V nominal
#define BATTERY_LIPO_4S       5   //  4S LiPo, 14.8 V nominal
#define BATTERY_LIPO_5S       6   //  5S LiPo, 18.5 V nominal
#define BATTERY_LIPO_6S       7   //  6S LiPo, 22.2 V nominal (⚠ near 24 V hw limit)
#define BATTERY_CUSTOM        99  // Set VBAT_WARN_V/CUTOFF_V/OVERVOLTAGE_V manually
#define BATTERY_TYPE    BATTERY_NIMH_10CELL   // ← change this line to switch battery
#if   BATTERY_TYPE == BATTERY_NIMH_8CELL
  #define VBAT_WARN_V           8.4f   // 8 × 1.05 V
  #define VBAT_CUTOFF_V         8.0f   // 8 × 1.00 V — disable motors (prevents over-discharge)
  #define VBAT_OVERVOLTAGE_V   12.5f   // above max charge (~8 × 1.45 V)
#elif BATTERY_TYPE == BATTERY_NIMH_10CELL
  #define VBAT_WARN_V           9.5f   // Reduced to prevent early warnings during load
  #define VBAT_CUTOFF_V         8.0f   // Reduced to 8.0V to handle high motor draw dips
  #define VBAT_OVERVOLTAGE_V   15.5f   // above max charge (~10 × 1.45 V)
#elif BATTERY_TYPE == BATTERY_LIPO_2S
  #define VBAT_WARN_V           7.0f   // 2 × 3.5 V
  #define VBAT_CUTOFF_V         6.6f   // 2 × 3.3 V — LiPo damage threshold
  #define VBAT_OVERVOLTAGE_V    8.6f   // above 2 × 4.3 V
#elif BATTERY_TYPE == BATTERY_LIPO_3S
  #define VBAT_WARN_V          10.5f   // 3 × 3.5 V
  #define VBAT_CUTOFF_V         9.9f   // 3 × 3.3 V
  #define VBAT_OVERVOLTAGE_V   12.9f   // above 3 × 4.3 V
#elif BATTERY_TYPE == BATTERY_LIPO_4S
  #define VBAT_WARN_V          14.0f   // 4 × 3.5 V
  #define VBAT_CUTOFF_V        13.2f   // 4 × 3.3 V
  #define VBAT_OVERVOLTAGE_V   17.2f   // above 4 × 4.3 V
#elif BATTERY_TYPE == BATTERY_LIPO_5S
  #define VBAT_WARN_V          17.5f   // 5 × 3.5 V
  #define VBAT_CUTOFF_V        16.5f   // 5 × 3.3 V
  #define VBAT_OVERVOLTAGE_V   21.5f   // above 5 × 4.3 V
#elif BATTERY_TYPE == BATTERY_LIPO_6S
  #define VBAT_WARN_V          21.0f   // 6 × 3.5 V
  #define VBAT_CUTOFF_V        19.8f   // 6 × 3.3 V
  #define VBAT_OVERVOLTAGE_V   24.0f   // hw limit; 6S full charge = 25.2 V (not measurable)
#elif BATTERY_TYPE == BATTERY_CUSTOM
  #define VBAT_WARN_V          10.5f
  #define VBAT_CUTOFF_V        10.0f
  #define VBAT_OVERVOLTAGE_V   16.0f
#else
  #error "Unknown BATTERY_TYPE — see BATTERY_TYPE options in config.h"
#endif
#define VBAT_LOW_THRESHOLD  VBAT_WARN_V
#define VBAT_MIN_PRESENT_V      2.0f
#define VSERVO_MIN_PRESENT_V    4.0f
#define VBAT_DIVIDER_R1         50000.0f  // Upper resistor (Ω)
#define VBAT_DIVIDER_R2         10000.0f  // Lower resistor (Ω)
#define VBAT_DIVIDER_RATIO      ((VBAT_DIVIDER_R1 + VBAT_DIVIDER_R2) / VBAT_DIVIDER_R2)
#define V5_DIVIDER_RATIO        2.0f
#define VSERVO_DIVIDER_RATIO    3.0f
#define ADC_VREF                5.0f    // 5V reference
#define ADC_RESOLUTION          1024    // 10-bit ADC
#define NEOPIXEL_COUNT          1       // Number of WS2812B LEDs
#define NEOPIXEL_BRIGHTNESS     64      // Default brightness (0-255)
#define PIN_ST1_LIMIT           PIN_LIM1  // Stepper 1 limit (40)
#define PIN_M1_LIMIT        PIN_LIM5
#define LIMIT_ACTIVE_LOW        1       // 1 = active low, 0 = active high
#define DEBUG_PINS_ENABLED      0
#if DEBUG_PINS_ENABLED
  #define DEBUG_PIN_ENCODER_ISR   A7    // HIGH inside any encoder ISR
  #define DEBUG_PIN_STEPPER_ISR   A8    // HIGH inside Timer3 (stepper) ISR
  #define DEBUG_PIN_UART_LATE     A9    // Pulse when taskUART() wall-clock > 10 ms (ISR inflation, not a real error)
  #define DEBUG_PIN_PID_LOOP      A10   // HIGH inside Timer1 (PID) ISR
  #define DEBUG_PIN_UART_TASK     A11   // HIGH for entire taskUART() execution
  #define DEBUG_PIN_UART_RX       A12   // HIGH during processIncoming() only
  #define DEBUG_PIN_UART_TX       A13   // HIGH during sendTelemetry() only
#endif
#if (ENCODER_1_MODE != ENCODER_2X && ENCODER_1_MODE != ENCODER_4X)
  #error "ENCODER_1_MODE must be ENCODER_2X or ENCODER_4X"
#endif
#if (ENCODER_2_MODE != ENCODER_2X && ENCODER_2_MODE != ENCODER_4X)
  #error "ENCODER_2_MODE must be ENCODER_2X or ENCODER_4X"
#endif
#if (ENCODER_3_MODE != ENCODER_2X && ENCODER_3_MODE != ENCODER_4X)
  #error "ENCODER_3_MODE must be ENCODER_2X or ENCODER_4X"
#endif
#if (ENCODER_4_MODE != ENCODER_2X && ENCODER_4_MODE != ENCODER_4X)
  #error "ENCODER_4_MODE must be ENCODER_2X or ENCODER_4X"
#endif
#if STATUS_REPORTER_ENABLED && (STATUS_REPORT_HZ < 1)
  #error "STATUS_REPORT_HZ must be >= 1 when STATUS_REPORTER_ENABLED=1"
#endif
