yebrian1/Project-NUEVO/zoomed_test_onnx.py

import numpy as np
import cv2
import os
import onnxruntime as ort
from PIL import Image

# MediaPipe standard import (works since the downgrade)
import mediapipe as mp
mp_face_detection = mp.solutions.face_detection

# Enable HEIC image support for phone photos
from pillow_heif import register_heif_opener
register_heif_opener()

def preprocess_for_onnx(crop_rgb):
    """
    Manually replicates PyTorch's transforms.Compose:
    Resize -> ToTensor (Scale to 0-1 & CHW) -> Normalize
    """
    # 1. Resize to exactly 224x224
    img_resized = cv2.resize(crop_rgb, (224, 224))
    
    # 2. Convert to float32 and scale pixel values from [0, 255] to [0.0, 1.0]
    img_float = img_resized.astype(np.float32) / 255.0
    
    # 3. Apply ImageNet Normalization means and standard deviations
    mean = np.array([0.485, 0.456, 0.406], dtype=np.float32)
    std = np.array([0.229, 0.224, 0.225], dtype=np.float32)
    img_normalized = (img_float - mean) / std
    
    # 4. PyTorch/ONNX expects Channels-First (CHW), OpenCV provides Channels-Last (HWC)
    # Transpose dimensions from (224, 224, 3) to (3, 224, 224)
    img_chw = np.transpose(img_normalized, (2, 0, 1))
    
    # 5. Add the Batch dimension so the final shape is (1, 3, 224, 224)
    input_tensor = np.expand_dims(img_chw, axis=0)
    
    return input_tensor

def numpy_softmax(x):
    """Computes softmax probabilities for an array of raw logits."""
    # Subtract max for numerical stability before calculating exponentials
    e_x = np.exp(x - np.max(x, axis=1, keepdims=True))
    return e_x / e_x.sum(axis=1, keepdims=True)

def run_onnx_scrubber(data_root):
    test_dir = os.path.join(data_root, 'zoomed_test')
    if not os.path.exists(test_dir):
        print(f"Error: Directory '{test_dir}' not found.")
        return

    valid_exts = ('.jpg', '.jpeg', '.png', '.ppm', '.bmp', '.pgm', '.tif', '.tiff', '.webp', '.heic')
    image_files = [f for f in os.listdir(test_dir) if f.lower().endswith(valid_exts)]
    
    if not image_files:
        print(f"No images found in {test_dir}.")
        return
        
    print(f"Found {len(image_files)} zoomed images. Booting ONNX pipeline...")

    # 1. Initialize ONNX Runtime Session (Pure CPU execution)
    onnx_path = os.path.join(data_root, 'mobilenet_customer_classifier.onnx')
    if not os.path.exists(onnx_path):
        print(f"Error: ONNX model not found at {onnx_path}")
        return
        
    session = ort.InferenceSession(onnx_path, providers=['CPUExecutionProvider'])
    input_name = session.get_inputs()[0].name

    # 2. MediaPipe Face Detection Setup
    face_detector = mp_face_detection.FaceDetection(min_detection_confidence=0.5, model_selection=1)

    classes = ['boy', 'girl'] # Adjust based on your alphabetical folder structure
    current_idx = 0

    print("\n--- CONTROLS ---")
    print("Press 'D' -> Next Image")
    print("Press 'A' -> Previous Image")
    print("Press 'ESC' -> Exit Viewer\n")
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
