yebrian1/Project-NUEVO/(commit log)

2026-02-25 upadted PCB folder name
    [NUEVO board Rev. B.epro]
2026-03-17 udpated battery voltage
2026-03-22 added IMU calibraion ui
2026-03-22 added sensor define gauds
2026-03-26 fixed enable mask bug
    [message_router.py, ros_conversions.py, test_message_router_compact_tlv.py]
2026-04-04 Add runtime odometry parameter updates. Thread the new odom config through firmware, bridge, and robot APIs.
2026-04-07 blocking methods api fixes
    [robot.py]
2026-04-13 lidar update
2026-04-17 absolute cookery, got elevator stepper and gripper hardcoded
2026-04-22 Enhance robot path tracking and control parameters
    Added TAG_ID for aruco tracking and updated path control points. Adjusted lookahead distance and modified velocity commands.
2026-05-06 working object avoidance code implemented
    [main.py, path_planner.py, robot.py]
2026-05-06 working object avoidance code implemented again
    [obstacleavoidance1.py]
2026-05-06 working camera rahhh
2026-05-13 camera detection for green, red lights and stop signs, and motion based on signs
2026-05-20 improved sequence robustness, removed homing, and tuned navigation
2026-05-22 working manual maze navigation, half working GPS (too much jitter)
    [burgerandmaze.py, burgerpickup.py, lidar_testing.py, main.py, main_gps_maze.py, path_planner2.py]
2026-05-27 added lidar testing and pickup with lidar sensing
2026-06-02 goes up ramp, startup sequence, obstacle avoidance somewhat
    [burgerandmaze_w_lidar.py, gpsv3.py, lidar_detection_test.py, lidar_helpers.py, lidar_testing.py, obstacleavoidance2.py, obstacleavoidance3.py, obstacleavoidance4.py]
2026-06-03 Refactor wall alignment logic into reusable helper functions and optimize lidar processing.
    - Implemented robot_align_front, robot_align_left, and robot_align_right in lidar_helpers.py.
    - Added variance-based robustness to wall detection to handle perfectly aligned cases.
    - Simplified main.py to use a streamlined FSM with smooth P-control alignment.
    - Improved completion detection and added fail-safe timeouts for wall searching.
    - Updated LIDAR outlier filtering and plotting for better debug visibility.
    [combinedgpsmaze.py, config.h, gps_v5.py, gpsv6.py, lidar_helpers.py, lidar_testing.py, lidar_wall_aligner.py, obstacleavoidance5.py]
2026-06-05 we got to gender part success
    - Stabilized UART communication by isolating Bridge to Core 0.
    - Implemented smart standby for Vision node to reduce CPU load.
    - Resolved 'Another motion is still running' FSM race condition.
    - Reached gender identification phase successfully.
    [FINAL_burger_assembly.py, burger_assembly2.py, config.h, face_detect_test.py, face_helpers.py, gpsv8.py, grand_mission_integration.py, integrated_mission.py]
2026-06-09 chore: reduce UART baud rate to 115200 and update mission parameters
2026-06-09 chore: increase UART baud rate to 500000 and optimize LAPF tuning
2026-06-09 chore: safer UART, permanent max fan, increased speeds, and perfected dropoff/ramp sequences
    - Reduced UART baud rate to 250000 for better stability
    - Configured fan to permanent maximum speed to prevent thermal throttling
    - Increased robot speeds across multiple FSM states for improved performance
    - Perfected delivery dropoff and maze ramp sequences for reliability
    - Implemented velocity command throttling to optimize UART bandwidth
    - Stability improvements to POST_SCAN_WALL_FOLLOW logic
    - Created backup main_brian_6-9_night_nice.py
    [config.h, config.py, main_brian_6-9_night_nice.py]
2026-06-13 Fix formatting in README.md for features and sensors
